Alexandr-Filatov/Inductor-80kWt/Docs/PCB description.txt

Layers: 6
Thickness： 2mm
Copper Thickness： 1oz
Surface Treatment： HSAL LF
Solder Maske： Black Mate
Text Color： White
