Alexandr-Filatov/Inductor-80kWt/3D/Driver_Inductor.step

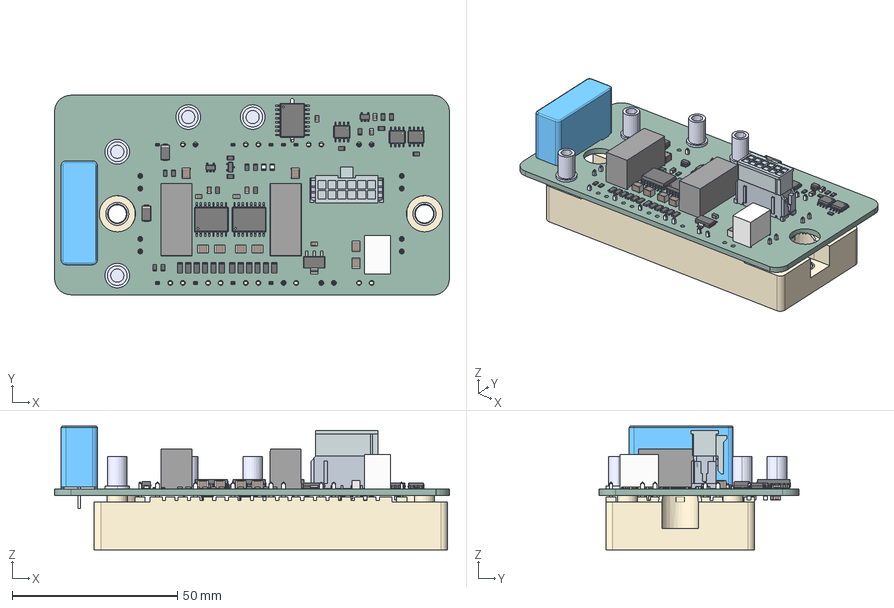
[picture p1: CAD file, 2024-11-18]
3D/Driver_Inductor.step
119.6 x 60.5 x 37.5 mm
SOT_23
SOIC_16W_75x103mm_P127mm x 3
R_0805_2012Metric x 18
R_1206_3216Metric x 12
C_0805_2012Metric x 19
SOT_223
K78_M-1000R3
C_1210_3225Metric x 8
SOIC_8_39x49mm_P127mm x 3
A976C64+2pins
D_SMA x 2
LED_0805_2012Metric x 2
M719
SOT_23_5 x 2
Втулка М4 6х10 x 4
WR_S-1WR2_ASM x 2
430251210wbm000_01
D_SOD_123 x 2
Driver_Inductor_PCB
