Alexandr-Filatov/Inductor-80kWt/3D/K78xxM-1000R3.stp

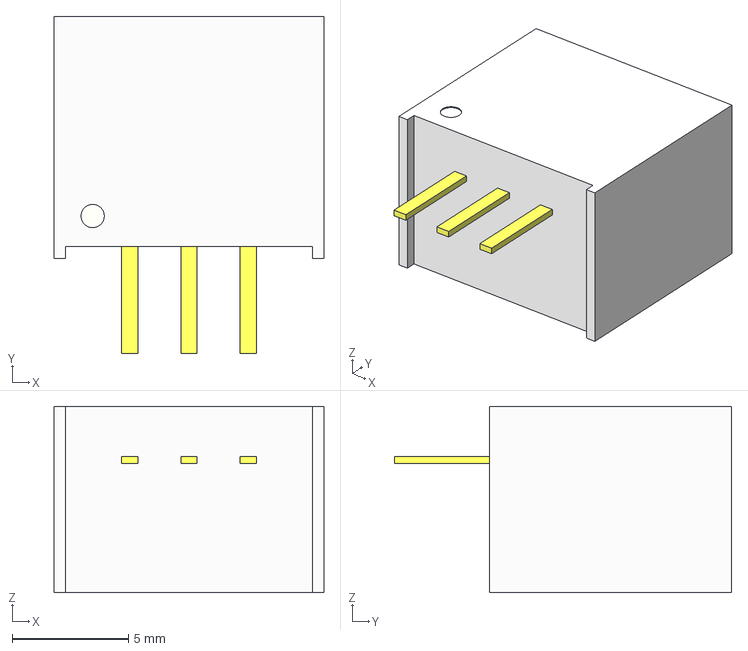
[picture p2: CAD file, 2024-10-08]
3D/K78xxM-1000R3.stp
11.6 x 14.5 x 8.00 mm
