Alexandr-Filatov/Inductor-80kWt/3D/Втулка М4 6х10.STEP

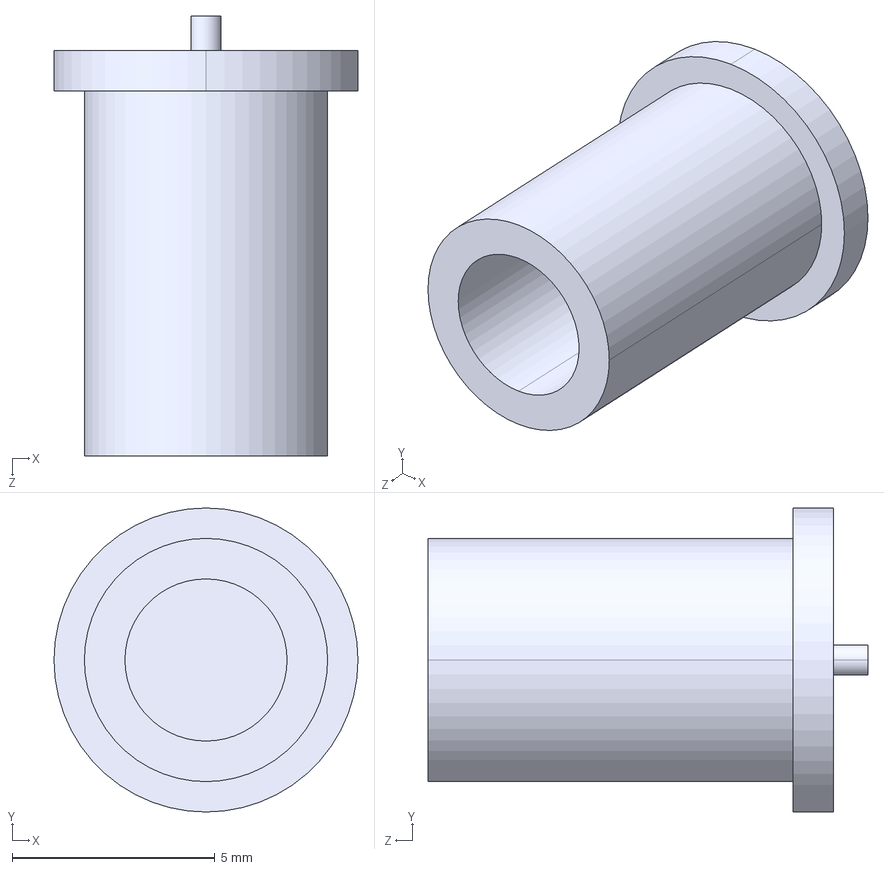
[picture p3: CAD file, 2024-10-08]
3D/Втулка М4 6х10.STEP
7.50 x 7.50 x 10.8 mm
