Alexandr-Filatov/Inductor-80kWt/3D/M719.stp

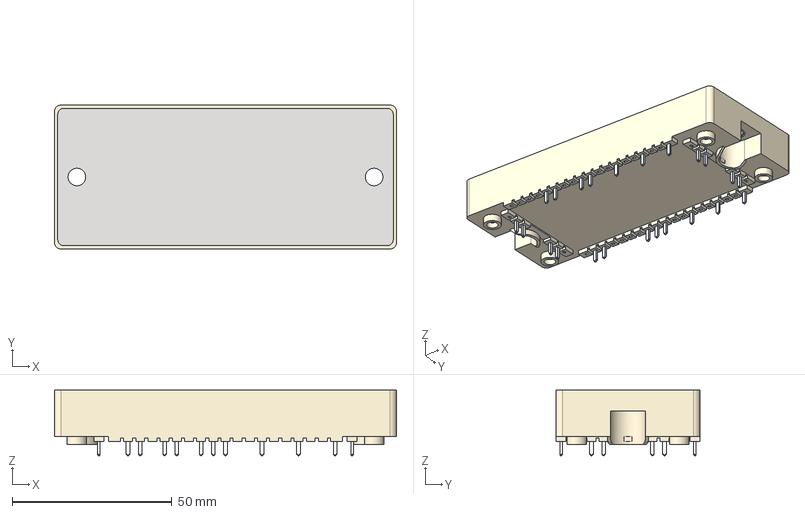
[picture p5: CAD file, 2023-04-18]
3D/M719.stp
107.0 x 45.0 x 20.5 mm
M719_body
M719_plate
M719_pin x 23
