Alexandr-Filatov/Inductor-80kWt/3D/430251210.stp

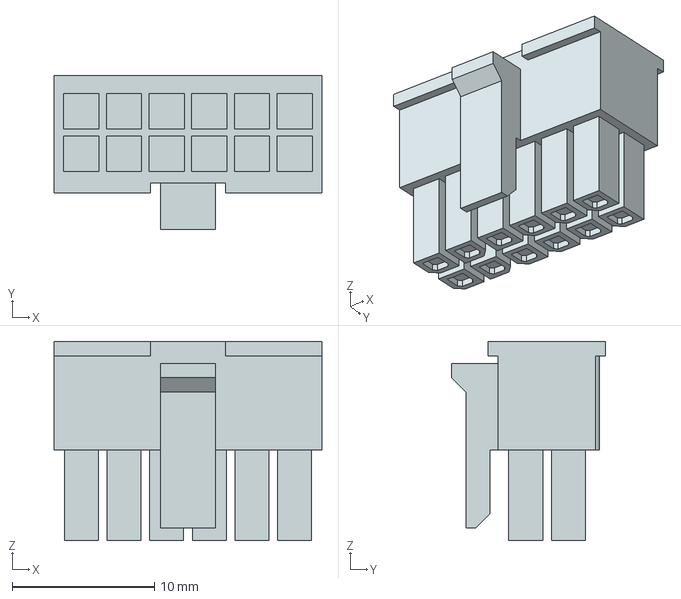
[picture p6: CAD file, 2024-11-18]
3D/430251210.stp
18.9 x 10.8 x 14.0 mm
