Alexandr-Filatov/Inductor-80kWt/3D/B32674D6105K000.stp

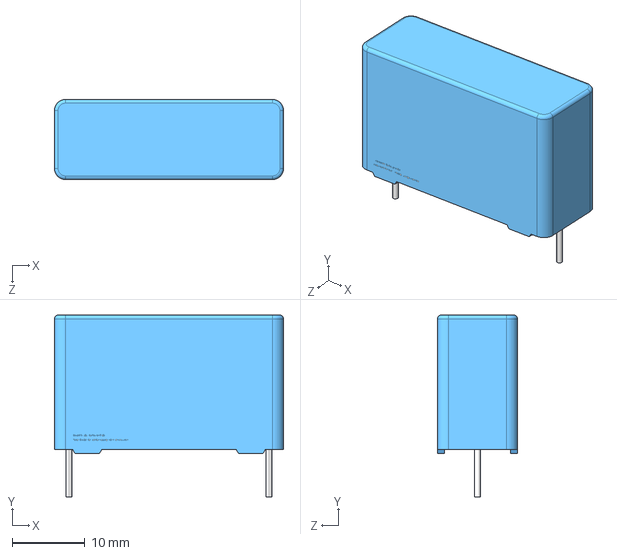
[picture p7: CAD file, 2024-10-31]
3D/B32674D6105K000.stp
31.5 x 25.0 x 11.0 mm
