Alexandr-Filatov/Inductor-80kWt/3D/430451212.stp

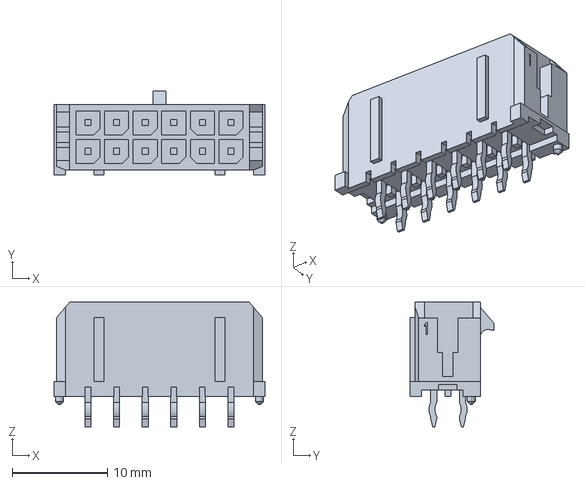
[picture p8: CAD file, 2024-10-07]
3D/430451212.stp
22.1 x 8.77 x 13.1 mm
