Alexandr-Filatov/Inductor-80kWt/Docs/Driver_Inductor.pdf

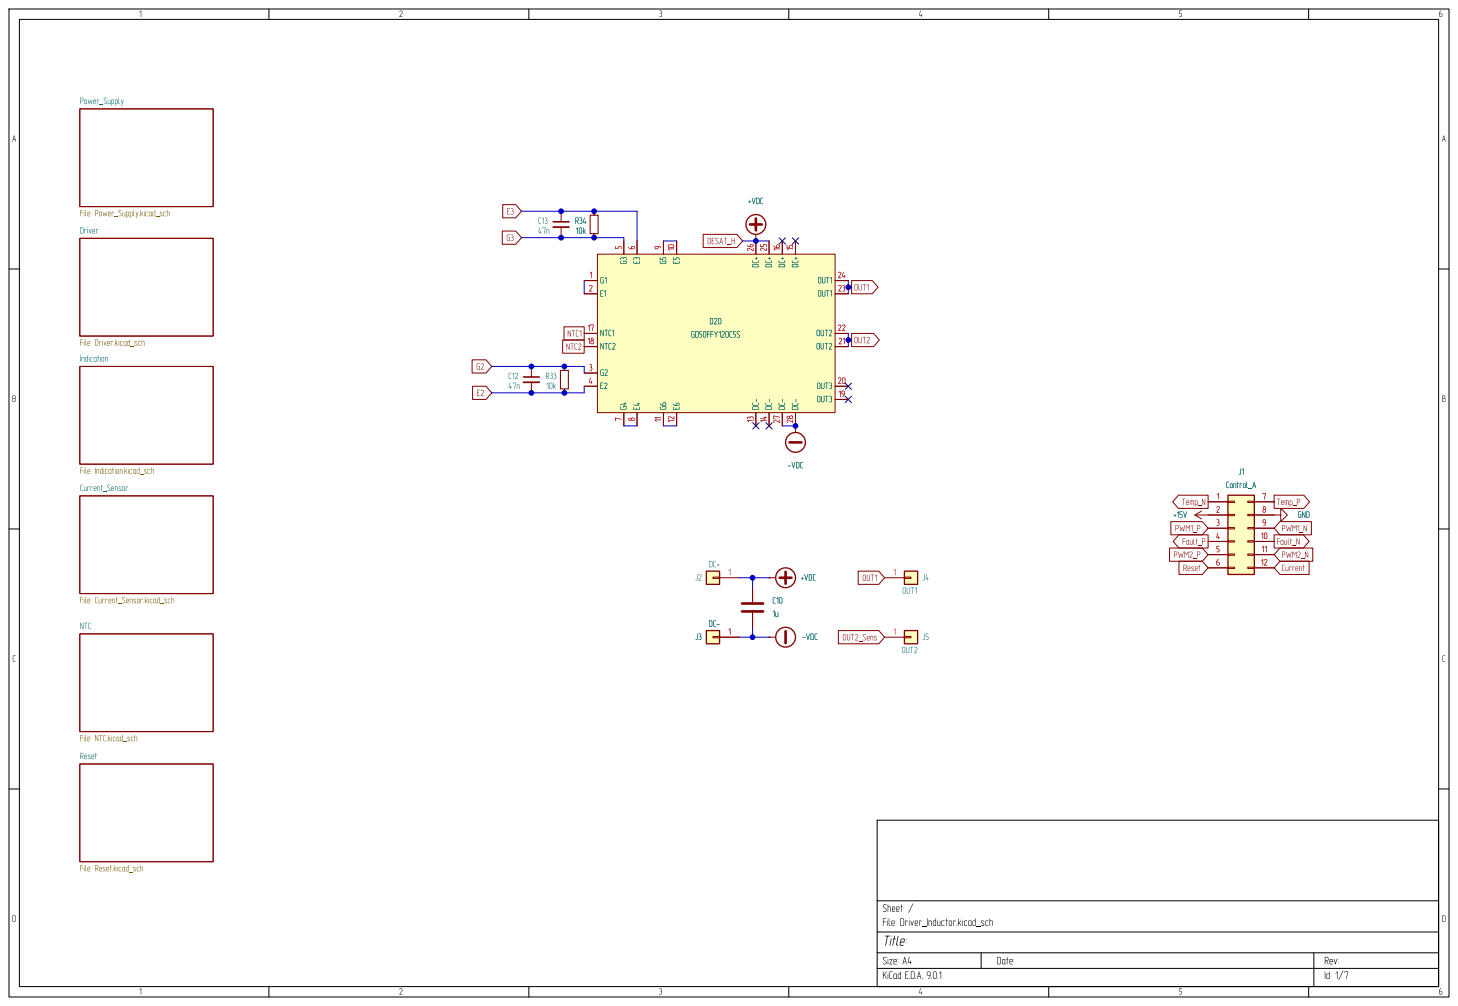
[picture p9: page 1]

Driver File:Driver.kicad_sch Power_Supply File:Power_Supply.kicad_sch NTC

9 G6 11 E5 10 E6 12 DC+26 DC- 13 DC+25 DC- 14 DC+16 DC- 27 DC+15 DC- 28 OUT124 OUT123 OUT222 OUT221 OUT320 OUT319 D20 GD50FFY120C5S

9 G6 11 E5 10 E6 12 DC+26 DC- 13 DC+25 DC- 14 DC+16 DC- 27 DC+15 DC- 28 OUT124 OUT123 OUT222 OUT221 OUT320 OUT319 +VDC

File:NTC.kicad_sch Reset File:Reset.kicad_sch

Id:1/7 Title: File:Driver_Inductor.kicad_sch Sheet:/

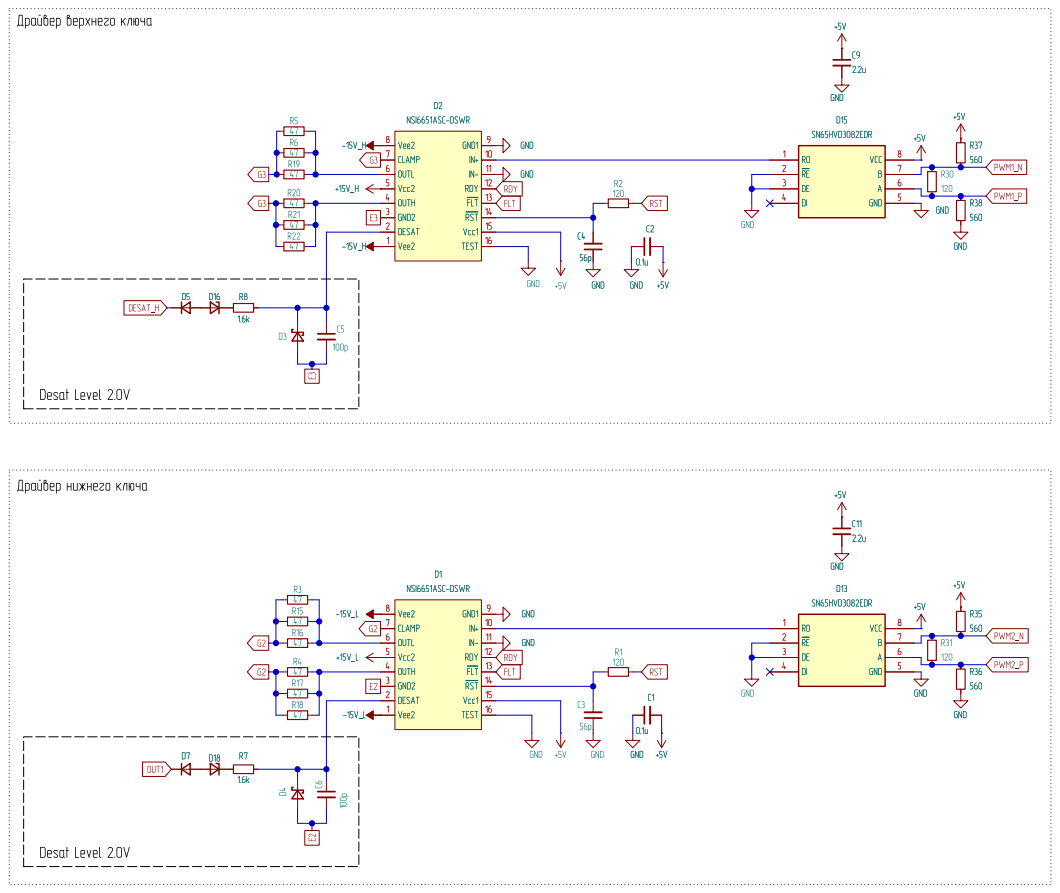
[picture p10: page 2]

DesatLevel2.0V

Id:2/7 Title: File:Driver.kicad_sch Sheet:/Driver/

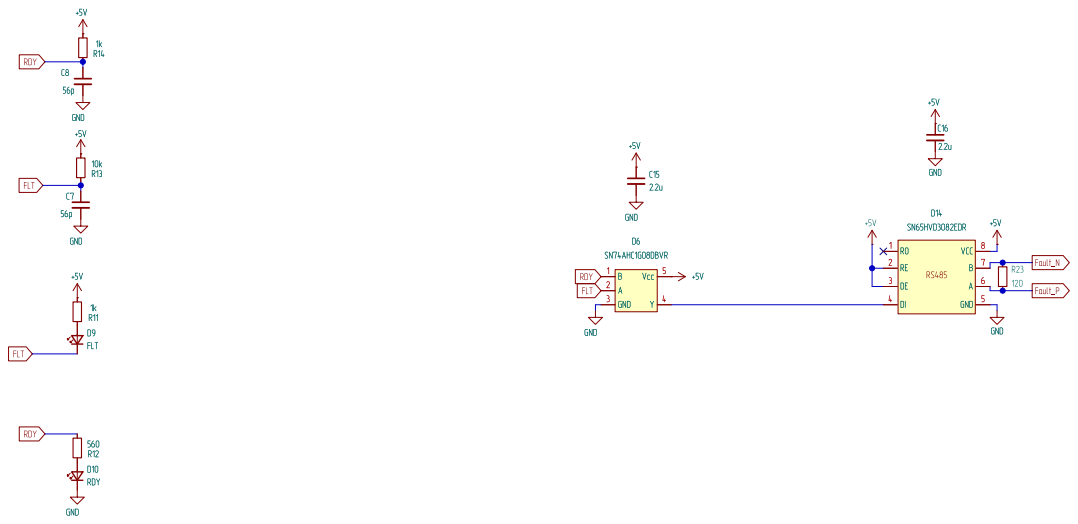
[picture p11: page 3]

Id:3/7 Title: File:Indication.kicad_sch Sheet:/Indication/ R12

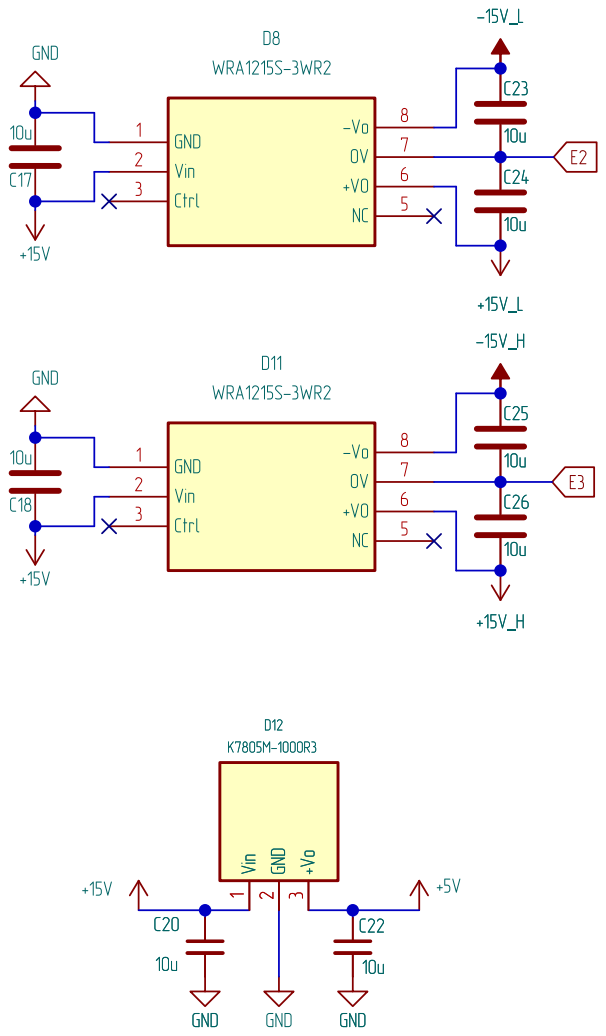
[picture p12: page 4]

Id:4/7 Title: File:Power_Supply.kicad_sch Sheet:/Power_Supply/ C26

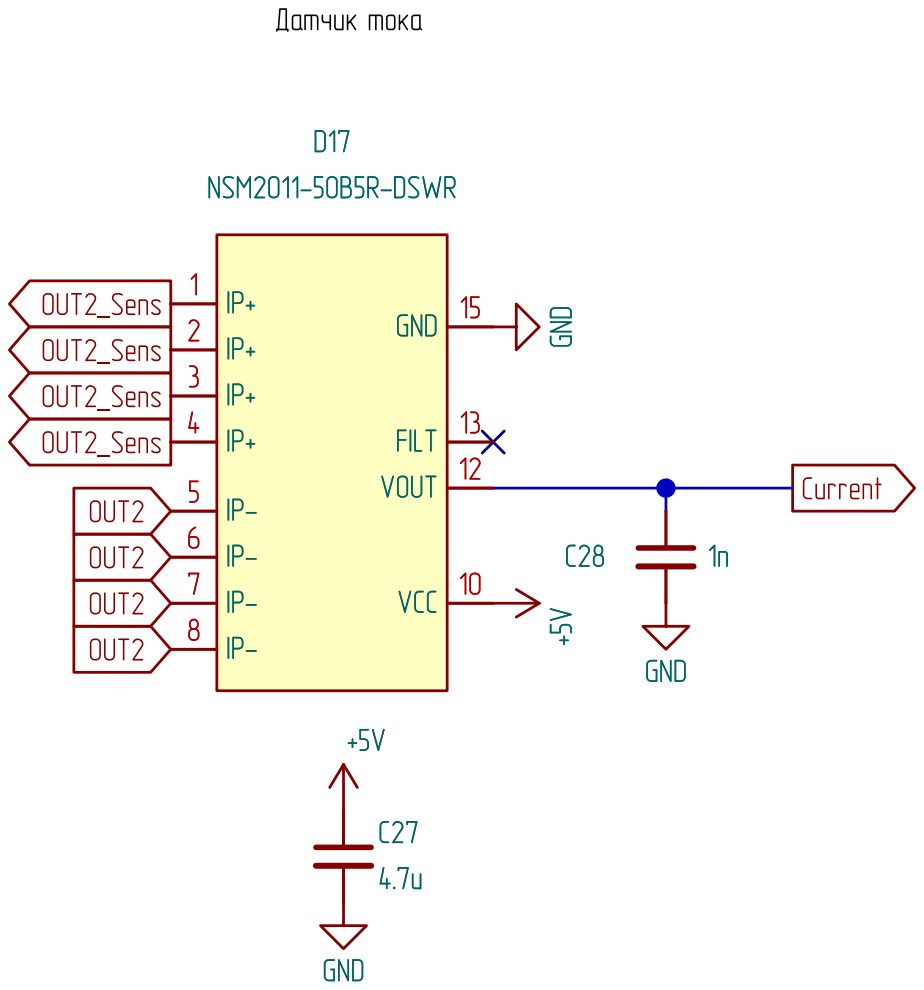
[picture p13: page 5]

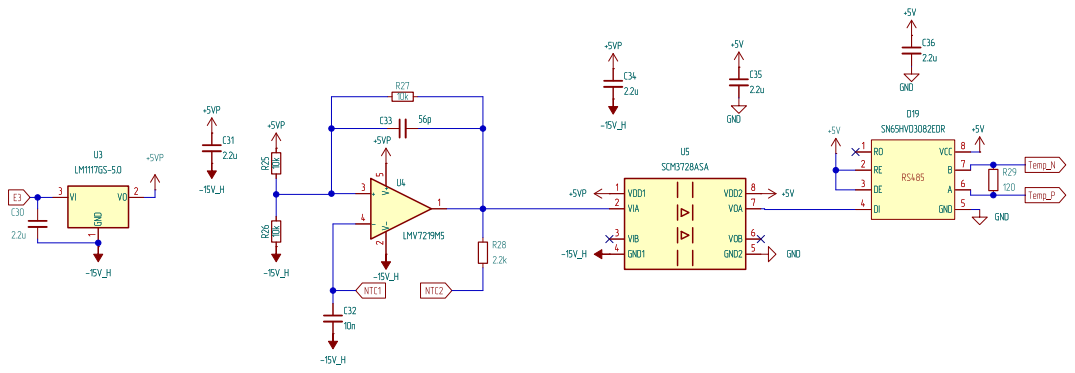
[picture p14: page 6]

Id:6/7 Title: File:NTC.kicad_sch Sheet:/NTC/

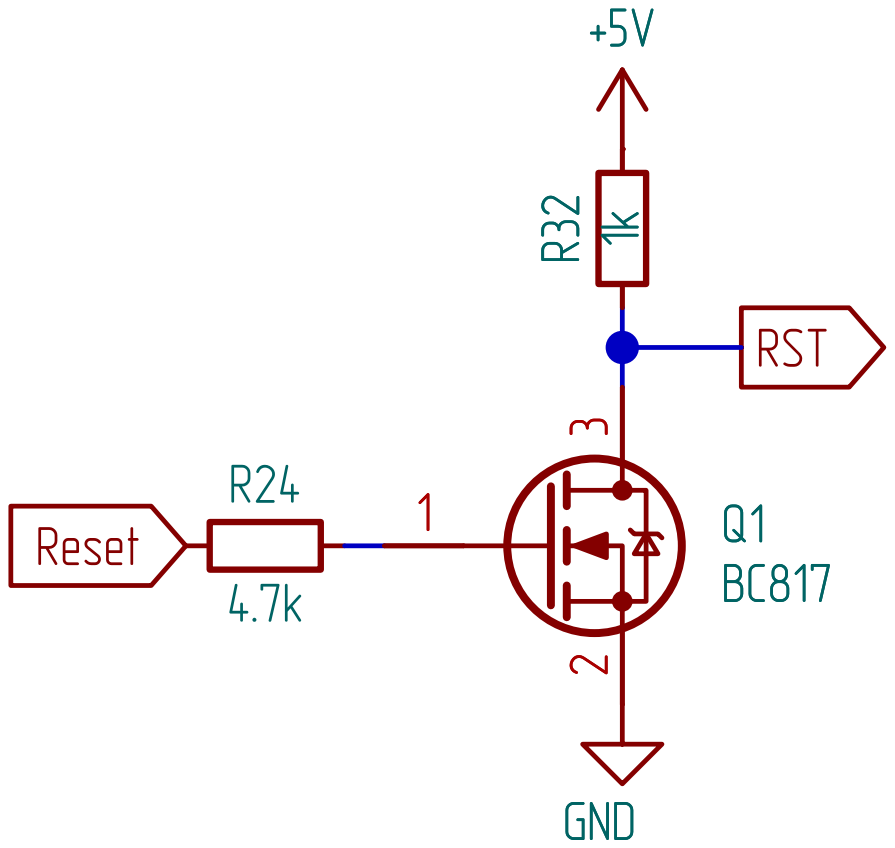
[picture p15: page 7]

Id:7/7 Title: File:Reset.kicad_sch Sheet:/Reset/
