Alexandr-Filatov/Inductor-80kWt/Docs/Driver_Inductor_2.1-B_Fab.pdf

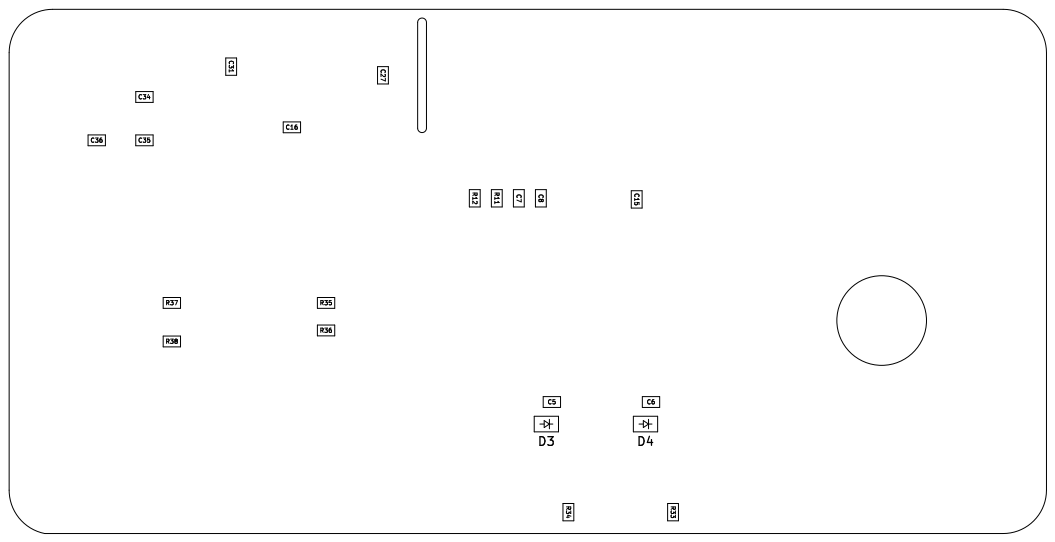
[picture p16: page 1]

Id: 1/1 Title: File: Driver_Inductor.kicad_pcb Sheet:
