Alexandr-Filatov/Inductor-80kWt/Docs/Driver_Inductor_2.1-F_Fab.pdf

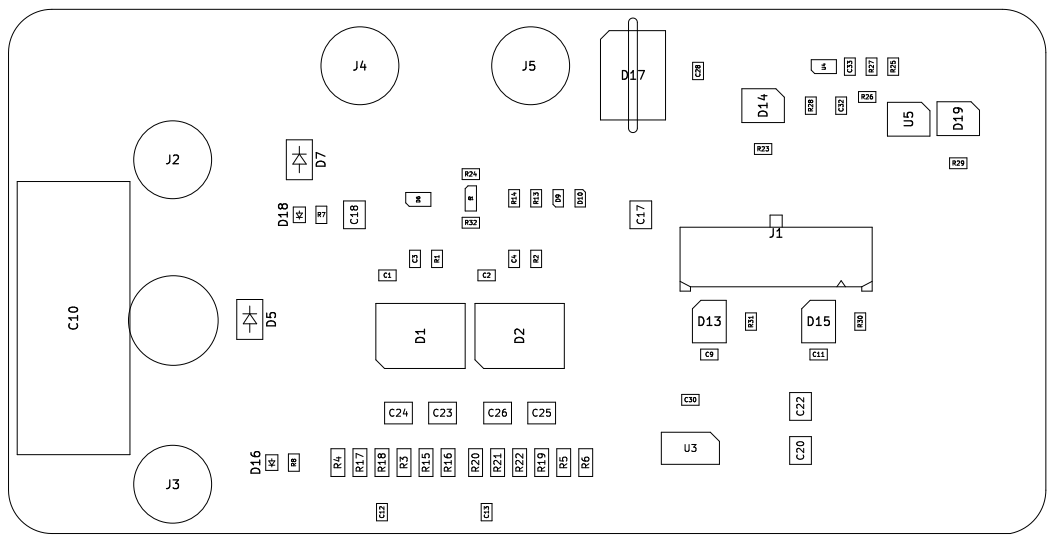
[picture p17: page 1]

Id: 1/1 Title: File: Driver_Inductor.kicad_pcb Sheet:
