Alexandr-Filatov/Inductor-80kWt/(list of files, drawings)

Other design files:
K78xxM-1000R3 (1).SchLib
K78xxM-1000R3 (3).SchLib
K78xxM-1000R3 负输出.PcbLib
K78xxM-1000R3.PcbLib
WRA_S-3WR2.PcbLib
WRA_S-3WR2.SchLib
