Alexandr-Filatov/Inductor-80kWt/Driver_Inductor.kicad_pcb

## KiCad design Driver_Inductor.kicad_pcb (2025-04-14)

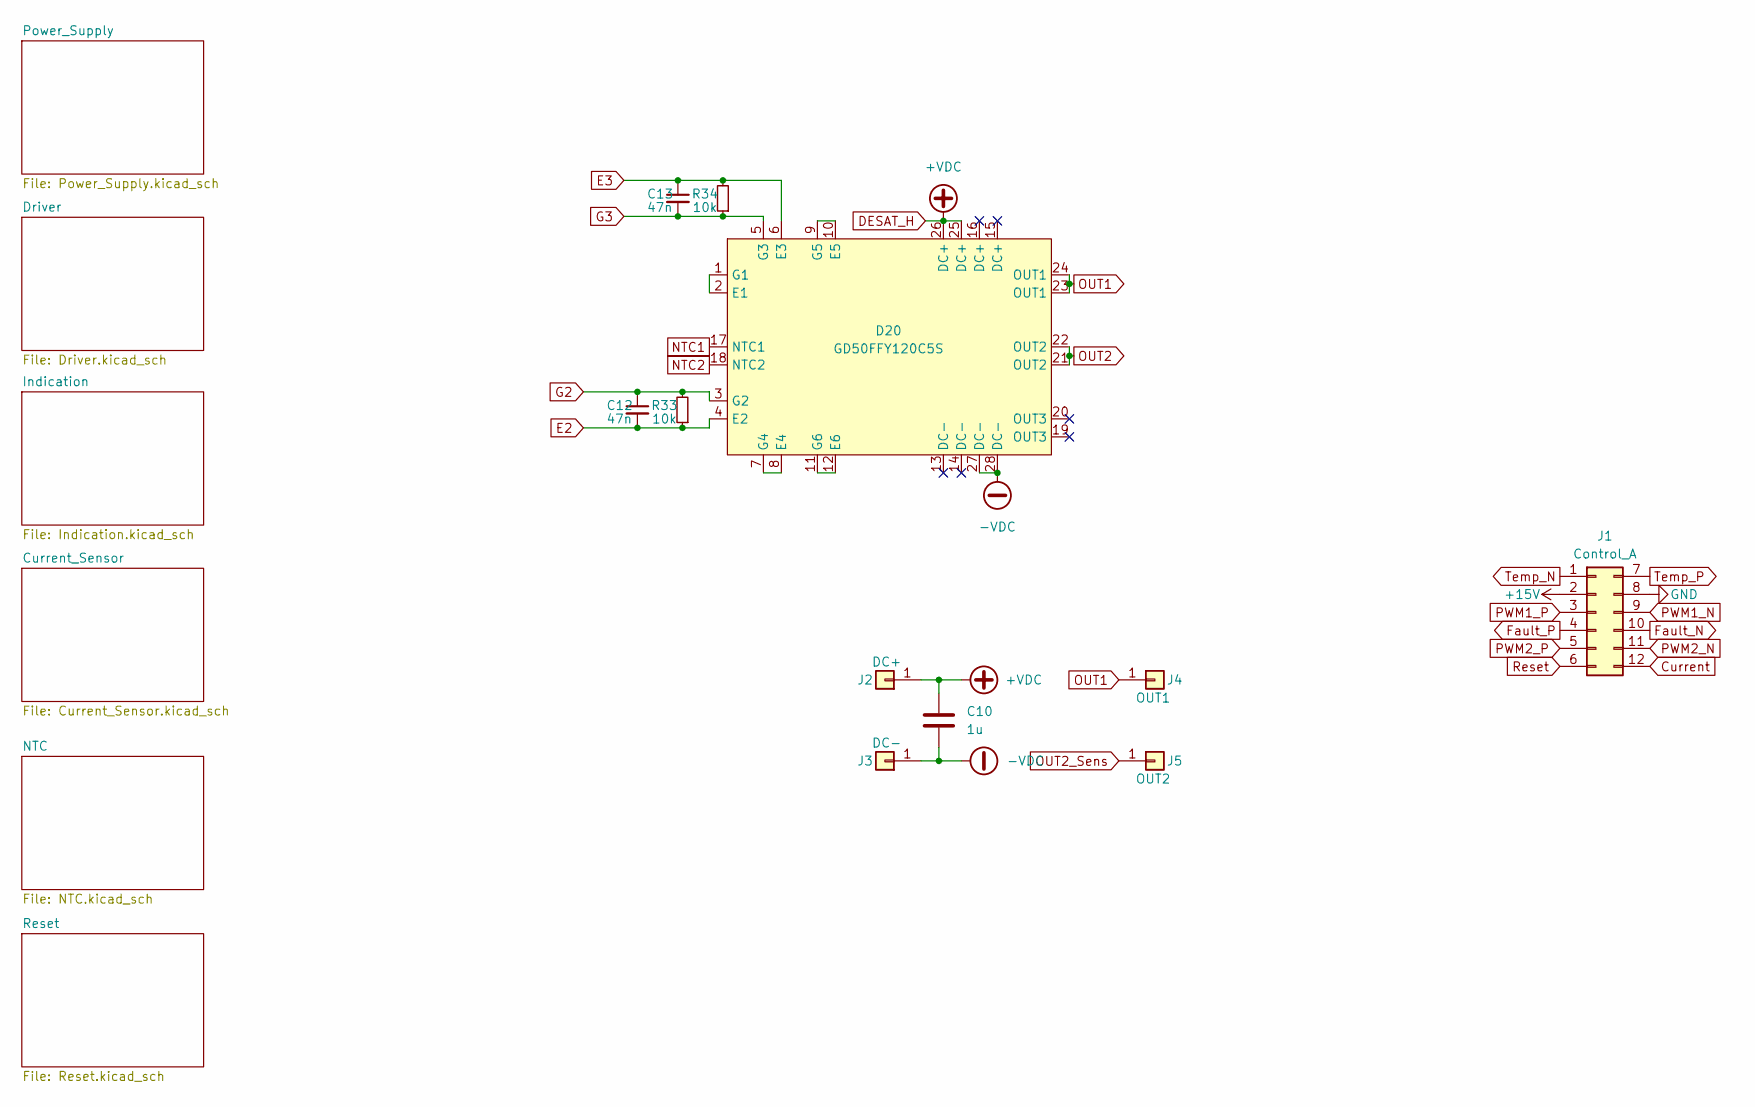
[picture p18: schematic Driver_Inductor.kicad_sch]

Parts:
C10: 1u; C_Rect_L31.5mm_W13.0mm_P27.50mm_MKS4
C12, C13: 47n; C_0805_2012Metric_Pad1.18x1.45mm_HandSolder
D20: GD50FFY120C5S
J1: Control_A; Molex_Micro-Fit_3.0_43045-1212_2x06_P3.00mm_Vertical
J2: DC+; Bush_M4
J3: DC-; Bush_M4
J4: OUT1; Bush_M4
J5: OUT2; Bush_M4
R33, R34: 10k; R_0805_2012Metric_Pad1.20x1.40mm_HandSolder

Connections:
+15V: J1.2; also elsewhere on the board
-VDC: C10.2, D20.27 (DC-), D20.28 (DC-), J3.1
Current: J1.12; also elsewhere on the board
DESAT_H: C10.1, D20.25 (DC+), D20.26 (DC+), J2.1; also elsewhere on the board
E2: C12.2, D20.4 (E2), R33.1; also elsewhere on the board
E3: C13.1, D20.6 (E3), R34.2; also elsewhere on the board
Fault_N: J1.10; also elsewhere on the board
Fault_P: J1.4; also elsewhere on the board
G2: C12.1, D20.3 (G2), R33.2; also elsewhere on the board
G3: C13.2, D20.5 (G3), R34.1; also elsewhere on the board
GND: J1.8; also elsewhere on the board
NTC1: D20.17 (NTC1); also elsewhere on the board
NTC2: D20.18 (NTC2); also elsewhere on the board
unnamed: D20.1 (G1), D20.2 (E1)
unnamed: D20.7 (G4), D20.8 (E4)
unnamed: D20.9 (G5), D20.10 (E5)
unnamed: D20.11 (G6), D20.12 (E6)
OUT1: D20.23 (OUT1), D20.24 (OUT1), J4.1; also elsewhere on the board
OUT2: D20.21 (OUT2), D20.22 (OUT2); also elsewhere on the board
OUT2_Sens: J5.1; also elsewhere on the board
PWM1_N: J1.9; also elsewhere on the board
PWM1_P: J1.3; also elsewhere on the board
PWM2_N: J1.11; also elsewhere on the board
PWM2_P: J1.5; also elsewhere on the board
Reset: J1.6; also elsewhere on the board
Temp_N: J1.1; also elsewhere on the board
Temp_P: J1.7; also elsewhere on the board

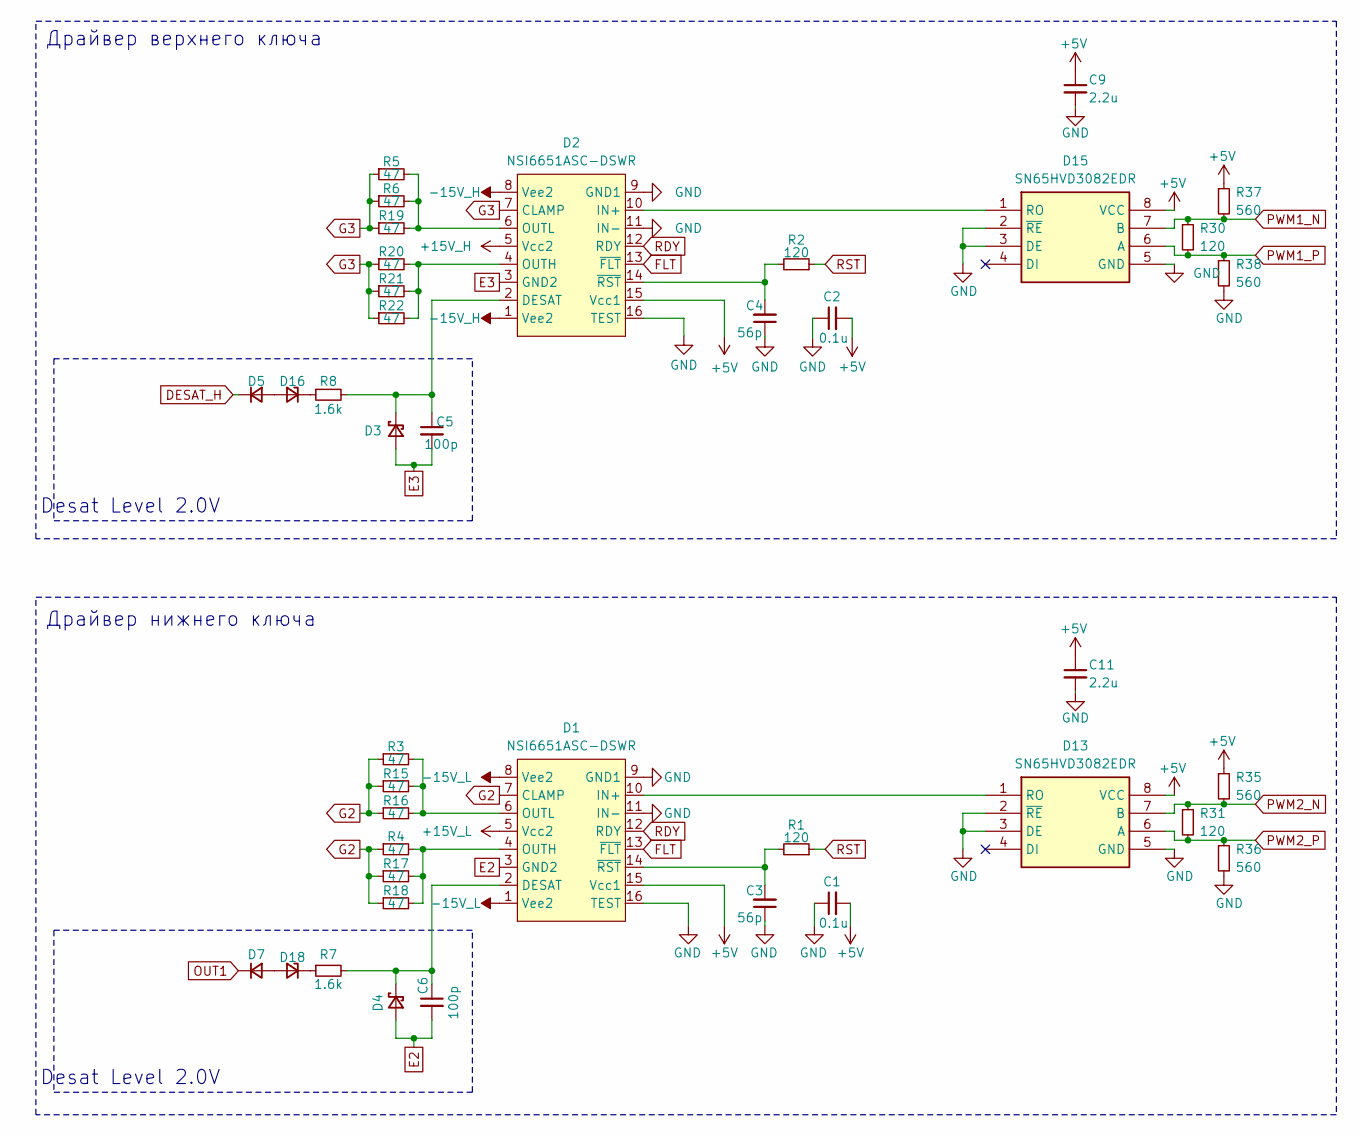
[picture p19: schematic Driver.kicad_sch]

Parts:
C1, C2: 0.1u; C_0805_2012Metric_Pad1.18x1.45mm_HandSolder
C3, C4: 56p; C_0805_2012Metric_Pad1.18x1.45mm_HandSolder
C5, C6: 100p; C_0805_2012Metric_Pad1.18x1.45mm_HandSolder
C9, C11: 2.2u; C_0805_2012Metric_Pad1.18x1.45mm_HandSolder
D1, D2: NSI6651ASC-DSWR; SOIC-16W_7.5x10.3mm_P1.27mm
D3, D4: MMSZ5240B; D_SOD-123
D5, D7: MURS160; D_SMA
D13, D15: SN65HVD3082EDR; SOIC-8_3.9x4.9mm_P1.27mm; Manufacturer_Part_Number ADM1485JRZ
D16, D18: 1SMB5919B; D_SOD-323_HandSoldering
R1, R2, R30, R31: 120; R_0805_2012Metric_Pad1.20x1.40mm_HandSolder
R3, R4, R5, R6, R15, R16, R17, R18, R19, R20, R21, R22: 47; R_1206_3216Metric_Pad1.30x1.75mm_HandSolder
R7, R8: 1.6k; R_0805_2012Metric_Pad1.20x1.40mm_HandSolder
R35, R36, R37, R38: 560; R_0805_2012Metric_Pad1.20x1.40mm_HandSolder

Connections:
+5V: C1.2, C2.2, C9.1, C11.1, D1.15 (Vcc1), D2.15 (Vcc1), D13.8 (VCC), D15.8 (VCC), R35.1, R37.1; also elsewhere on the board
+15V_H: D2.5 (Vcc2); also elsewhere on the board
+15V_L: D1.5 (Vcc2); also elsewhere on the board
-15V_H: D2.1 (Vee2), D2.8 (Vee2); also elsewhere on the board
-15V_L: D1.1 (Vee2), D1.8 (Vee2); also elsewhere on the board
DESAT_H: D5.1 (K); also elsewhere on the board
E2: C6.2, D1.3 (GND2), D4.2 (A); also elsewhere on the board
E3: C5.2, D2.3 (GND2), D3.2 (A); also elsewhere on the board
FLT: D1.13 (~FLT), D2.13 (~FLT); also elsewhere on the board
G2: D1.7 (CLAMP), R3.1, R4.1, R15.1, R16.1, R17.1, R18.1; also elsewhere on the board
G3: D2.7 (CLAMP), R5.1, R6.1, R19.1, R20.1, R21.1, R22.1; also elsewhere on the board
GND: C1.1, C2.1, C3.1, C4.1, C9.2, C11.2, D1.9 (GND1), D1.11 (IN-), D1.16 (TEST), D2.9 (GND1), D2.11 (IN-), D2.16 (TEST), D13.2 (~RE), D13.3 (DE), D13.5 (GND), D15.2 (~RE), D15.3 (DE), D15.5 (GND), R36.2, R38.2; also elsewhere on the board
unnamed: C6.1, D1.2 (DESAT), D4.1 (K), R7.2
unnamed: D1.10 (IN+), D13.1 (RO)
unnamed: D1.4 (OUTH), R4.2, R17.2, R18.2
unnamed: D1.6 (OUTL), R3.2, R15.2, R16.2
unnamed: C3.2, D1.14 (~RST), R1.2
unnamed: C5.1, D2.2 (DESAT), D3.1 (K), R8.2
unnamed: D2.4 (OUTH), R20.2, R21.2, R22.2
unnamed: D2.6 (OUTL), R5.2, R6.2, R19.2
unnamed: C4.2, D2.14 (~RST), R2.2
unnamed: D2.10 (IN+), D15.1 (RO)
unnamed: D5.2 (A), D16.2 (A)
unnamed: D16.1 (K), R8.1
unnamed: D7.2 (A), D18.2 (A)
unnamed: D18.1 (K), R7.1
OUT1: D7.1 (K); also elsewhere on the board
PWM1_N: D15.7 (B), R30.1, R37.2; also elsewhere on the board
PWM1_P: D15.6 (A), R30.2, R38.1; also elsewhere on the board
PWM2_N: D13.7 (B), R31.1, R35.2; also elsewhere on the board
PWM2_P: D13.6 (A), R31.2, R36.1; also elsewhere on the board
RDY: D1.12 (RDY), D2.12 (RDY); also elsewhere on the board
RST: R1.1, R2.1; also elsewhere on the board

Notes on the sheet:
Desat Level 2.0V
Драйвер нижнего ключа
Драйвер верхнего ключа

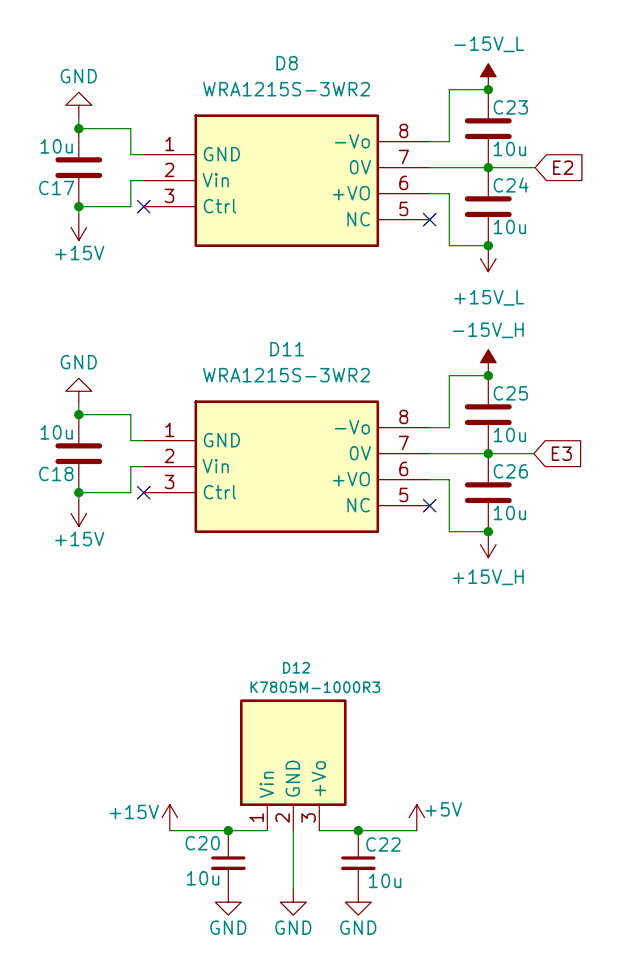
[picture p20: schematic Power_Supply.kicad_sch]

Parts:
C17, C18, C20, C22, C23, C24, C25, C26: 10u; C_1210_3225Metric_Pad1.33x2.70mm_HandSolder
D8, D11: WRA1215S-3WR2; WRA_S-3WR2
D12: K7805M-1000R3; K78xxM-1000R3

Connections:
+5V: C22.1, D12.3 (+Vo); also elsewhere on the board
+15V: C17.1, C18.1, C20.1, D8.2 (Vin), D11.2 (Vin), D12.1 (Vin); also elsewhere on the board
+15V_H: C26.2, D11.6 (+VO); also elsewhere on the board
+15V_L: C24.2, D8.6 (+VO); also elsewhere on the board
-15V_H: C25.1, D11.8 (-Vo); also elsewhere on the board
-15V_L: C23.1, D8.8 (-Vo); also elsewhere on the board
E2: C23.2, C24.1, D8.7 (0V); also elsewhere on the board
E3: C25.2, C26.1, D11.7 (0V); also elsewhere on the board
GND: C17.2, C18.2, C20.2, C22.2, D8.1 (GND), D11.1 (GND), D12.2 (GND); also elsewhere on the board

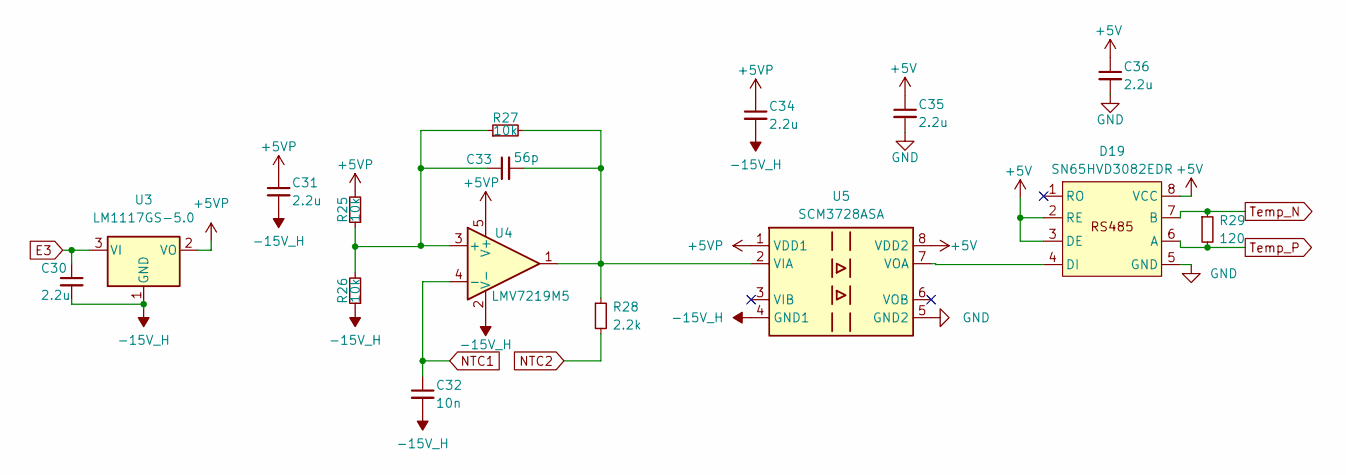
[picture p21: schematic NTC.kicad_sch]

Parts:
C30, C31, C34, C35, C36: 2.2u; C_0805_2012Metric_Pad1.18x1.45mm_HandSolder
C32: 10n; C_0805_2012Metric_Pad1.18x1.45mm_HandSolder
C33: 56p; C_0805_2012Metric_Pad1.18x1.45mm_HandSolder
D19: SN65HVD3082EDR; SOIC-8_3.9x4.9mm_P1.27mm
R25, R26, R27: 10k; R_0805_2012Metric_Pad1.20x1.40mm_HandSolder
R28: 2.2k; R_0805_2012Metric_Pad1.20x1.40mm_HandSolder
R29: 120; R_0805_2012Metric_Pad1.20x1.40mm_HandSolder
U3: LM1117GS-5.0; SOT-223
U4: LMV7219M5; SOT-23-5
U5: SCM3728ASA; SOIC-8_3.9x4.9mm_P1.27mm

Connections:
+5V: C35.1, C36.1, D19.2 (RE), D19.3 (DE), D19.8 (VCC), U5.8 (VDD2); also elsewhere on the board
+5VP: C31.1, C34.1, R25.2, U3.2 (VO), U4.5 (V+), U5.1 (VDD1)
-15V_H: C30.2, C31.2, C32.2, C34.2, R26.1, U3.1 (GND), U4.2 (V-), U5.4 (GND1); also elsewhere on the board
E3: C30.1, U3.3 (VI); also elsewhere on the board
GND: C35.2, C36.2, D19.5 (GND), U5.5 (GND2); also elsewhere on the board
NTC1: C32.1, U4.4 (-); also elsewhere on the board
NTC2: R28.2; also elsewhere on the board
unnamed: D19.4 (DI), U5.7 (VOA)
unnamed: C33.1, R25.1, R26.2, R27.1, U4.3 (+)
unnamed: C33.2, R27.2, R28.1, U4.1, U5.2 (VIA)
Temp_N: D19.7 (B), R29.1; also elsewhere on the board
Temp_P: D19.6 (A), R29.2; also elsewhere on the board

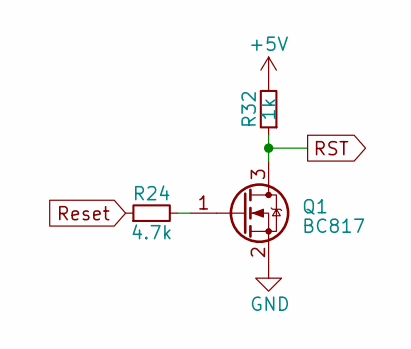
[picture p22: schematic Reset.kicad_sch]

Parts:
Q1: BC817; SOT-23
R24: 4.7k; R_0805_2012Metric_Pad1.20x1.40mm_HandSolder
R32: 1k; R_0805_2012Metric_Pad1.20x1.40mm_HandSolder

Connections:
+5V: R32.2; also elsewhere on the board
GND: Q1.2 (S); also elsewhere on the board
unnamed: Q1.1 (G), R24.2
RST: Q1.3 (D), R32.1; also elsewhere on the board
Reset: R24.1; also elsewhere on the board

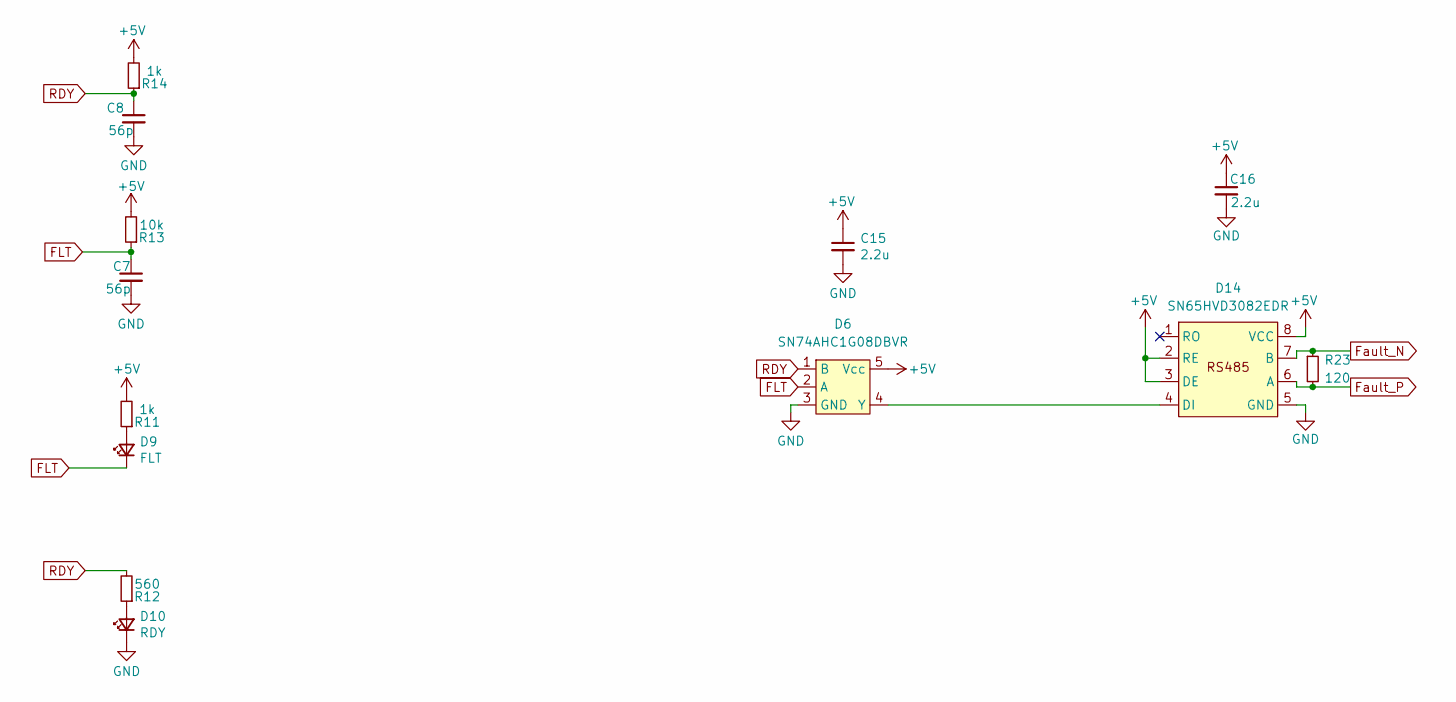
[picture p23: schematic Indication.kicad_sch]

Parts:
C7, C8: 56p; C_0805_2012Metric_Pad1.18x1.45mm_HandSolder
C15, C16: 2.2u; C_0805_2012Metric_Pad1.18x1.45mm_HandSolder
D6: SN74AHC1G08DBVR; SOT-23-5
D9: FLT; LED_0805_2012Metric_Pad1.15x1.40mm_HandSolder
D10: RDY; LED_0805_2012Metric_Pad1.15x1.40mm_HandSolder
D14: SN65HVD3082EDR; SOIC-8_3.9x4.9mm_P1.27mm
R11, R14: 1k; R_0805_2012Metric_Pad1.20x1.40mm_HandSolder
R12: 560; R_0805_2012Metric_Pad1.20x1.40mm_HandSolder
R13: 10k; R_0805_2012Metric_Pad1.20x1.40mm_HandSolder
R23: 120; R_0805_2012Metric_Pad1.20x1.40mm_HandSolder

Connections:
+5V: C15.1, C16.1, D6.5 (Vcc), D14.2 (RE), D14.3 (DE), D14.8 (VCC), R11.2, R13.2, R14.2; also elsewhere on the board
FLT: C7.1, D6.2 (A), D9.1 (K), R13.1; also elsewhere on the board
Fault_N: D14.7 (B), R23.1; also elsewhere on the board
Fault_P: D14.6 (A), R23.2; also elsewhere on the board
GND: C7.2, C8.2, C15.2, C16.2, D6.3 (GND), D10.1 (K), D14.5 (GND); also elsewhere on the board
unnamed: D9.2 (A), R11.1
unnamed: D10.2 (A), R12.1
unnamed: D6.4 (Y), D14.4 (DI)
RDY: C8.1, D6.1 (B), R12.2, R14.1; also elsewhere on the board

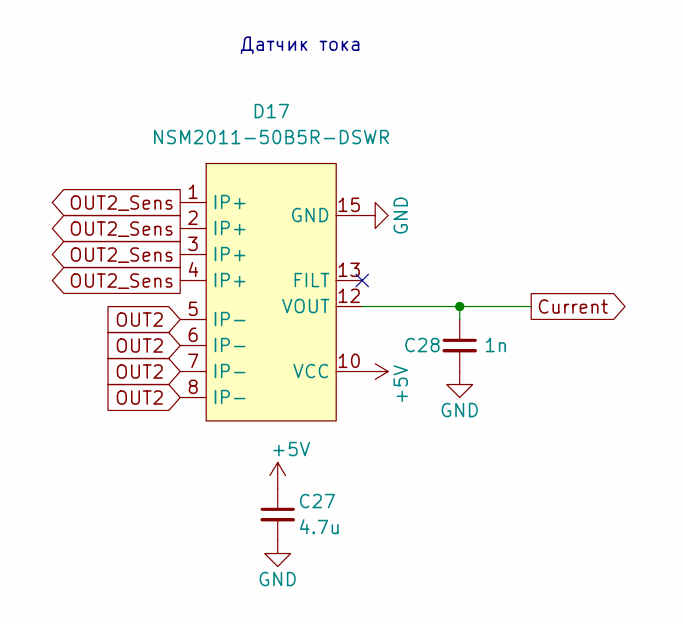
[picture p24: schematic Current_Sensor.kicad_sch]

Parts:
C27: 4.7u; C_0805_2012Metric_Pad1.18x1.45mm_HandSolder
C28: 1n; C_0805_2012Metric_Pad1.18x1.45mm_HandSolder
D17: NSM2011-50B5R-DSWR; SOIC-16W_7.5x10.3mm_P1.27mm

Connections:
+5V: C27.1, D17.10 (VCC); also elsewhere on the board
Current: C28.1, D17.12 (VOUT); also elsewhere on the board
GND: C27.2, C28.2, D17.15 (GND); also elsewhere on the board
OUT2: D17.5 (IP-), D17.6 (IP-), D17.7 (IP-), D17.8 (IP-); also elsewhere on the board
OUT2_Sens: D17.1 (IP+), D17.2 (IP+), D17.3 (IP+), D17.4 (IP+); also elsewhere on the board

Notes on the sheet:
Датчик тока

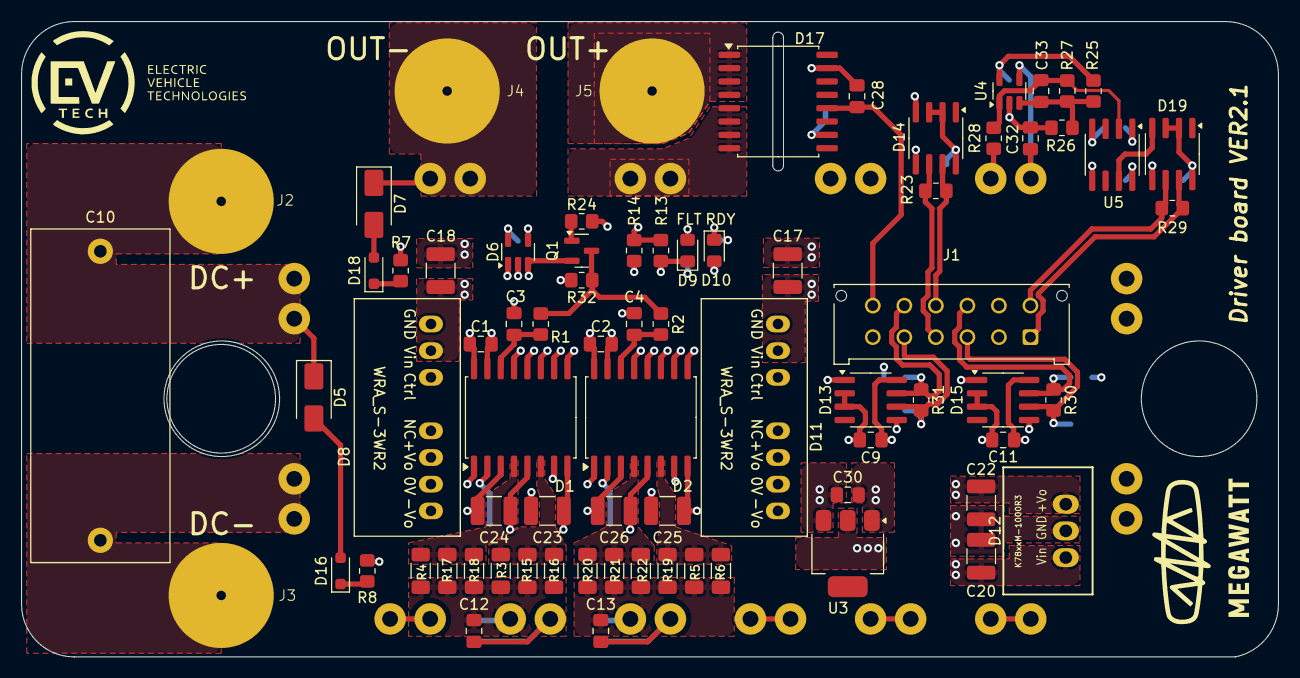
[picture p25: board Driver_Inductor.kicad_pcb from above]

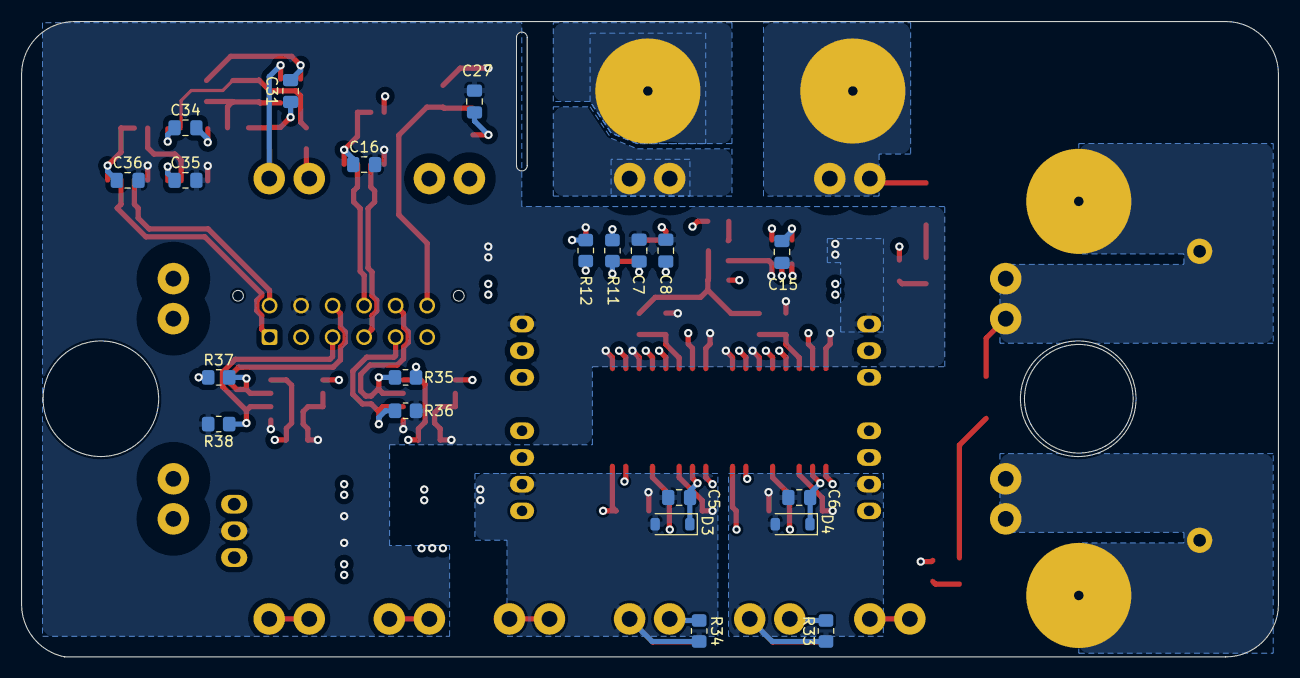
[picture p26: board Driver_Inductor.kicad_pcb from below]

Board: 6 copper layers, 119.6 x 60.5 mm, 97 parts (21 on the bottom side), 57 nets.
