Alexandr-Filatov/Inductor-80kWt/(commit log)

2023-10-03 Тестовая версия
    [Current_Sensor.kicad_sch, Driver.kicad_sch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]
2024-07-29 Заменил компаратор на пушпульный
    [Driver_Inductor.kicad_pcb]
2024-07-29 Сохранил изменения
2024-07-29 Сохранил изменения в схеме
    [Current_Sensor.kicad_sch, Driver.kicad_sch, Driver_Inductor.kicad_sch, Indication.kicad_sch, NTC.kicad_sch, Power_Supply.kicad_sch, Reset.kicad_sch]
2024-10-07 Убрал питание 3.3В
    [430451212.stp, Current_Sensor.kicad_sch, Driver.kicad_sch, Driver_Inductor.kicad_pcb, Driver_Inductor.kicad_sch, Indication.kicad_sch, NTC.kicad_sch, Power_Supply.kicad_sch]
2024-10-08 Развел все дорожки
    [Current_Sensor.kicad_sch, Driver.kicad_sch, Driver_Inductor.kicad_pcb, Driver_Inductor.kicad_sch, Indication.kicad_sch, K78xxM-1000R3 正输出.PcbLib, K78xxM-1000R3 负输出.PcbLib, K78xxM-1000R3 负输出.SchLib]
2024-10-09 Заменил в схеме символы питания
    [Driver_Inductor.kicad_pcb, Driver_Inductor.kicad_sch]
2024-10-31 VER2.0 Отправил в резонит
    [B32674D6105K000.stp, Current_Sensor.kicad_sch, Driver.kicad_sch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]
2024-10-31 VER2.0 Изменения: заменил 3D модель
    [Driver_Inductor.step]
2024-11-18 Изменения: добавил 5 вольтовые RS485 на вход драйверов
    [430251210.stp, Driver.kicad_sch, Driver_Inductor.kicad_pcb, Driver_Inductor.step]
2024-11-19 Изменения: изменил BOM, сделал заказ
    [Driver.kicad_sch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]
2025-02-22 VER2.1: внес все исправления для заказа в Китае
    [Driver.kicad_sch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]
2025-02-25 VER2.1: исправил BOM, наименования в схеме и добавил папку с документами
    [BOM_Driver_Inductor_2.1.xlsx, Driver.kicad_sch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]
2025-04-14 VER2.1: добавил файлы для сборки платы
    [Driver_Inductor.kicad_pcb]
2025-04-14 VER2.1: переименовал файлы для сборки
2025-05-21 VER2.1: добавил в доки схему
